diegoomataix/UPMSAT-2-STM-Model-Integration/README.md

# UPMSAT-2-STM-Model-Integration
 Integración modelo STM del UPMSAT-2
