diegoomataix/UPMSAT-2-STM-Model-Integration/STM check list.docx

STM ASSEMBLY – CHECK LIST

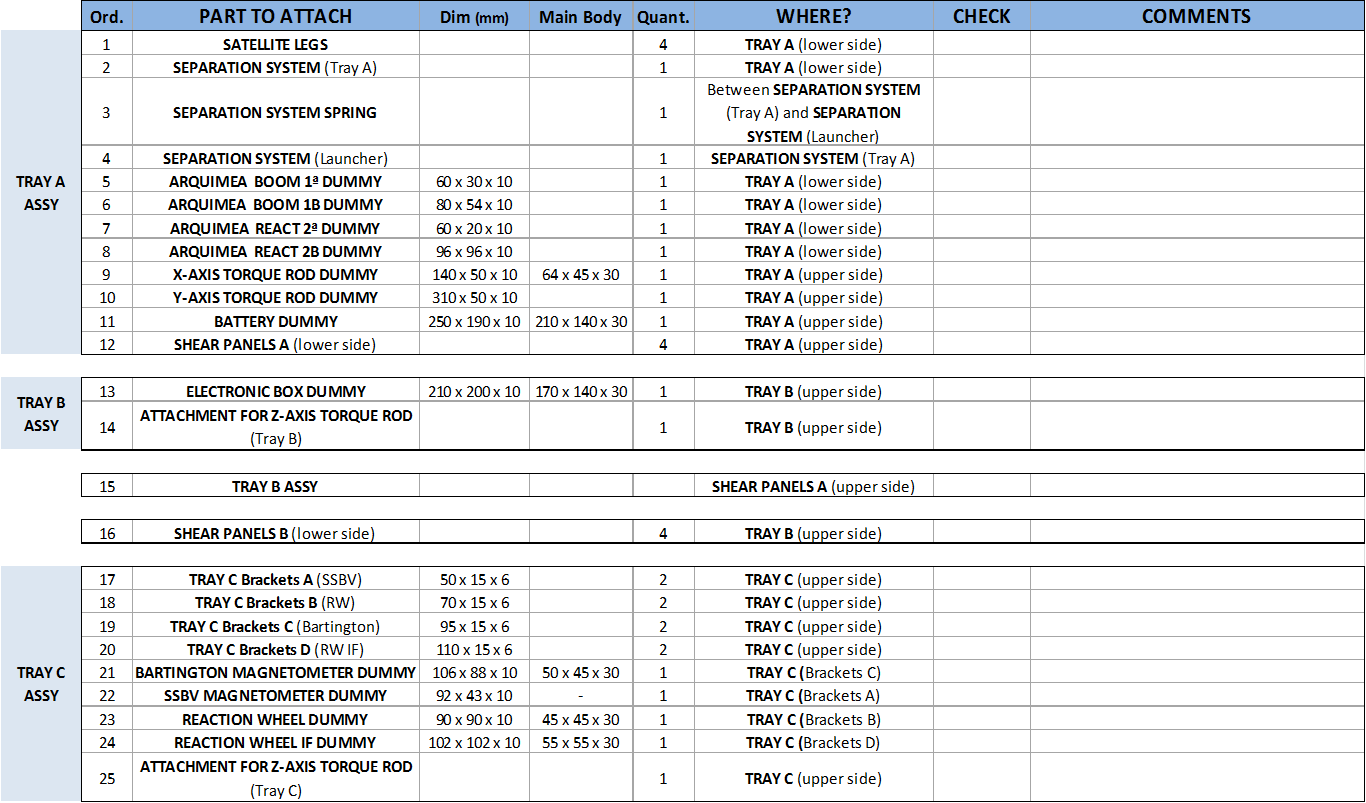
[picture p1: figure]

STM ASSEMBLY – FIXING ELEMENTS CHECK LIST
