diegoomataix/UPMSAT-2-STM-Model-Integration/qr_code_udf2.pdf

MUSE IDR

LEVEL | Bill of Material: US2‐E‐CM‐140000AP‐01A‐T_STM
1 | 2 | 3 | 4 | 5 | Part Number | Source | Definition | Material
x | | | | | US2‐E‐CM‐140100CP‐04H‐T_STRA | Made | TRAY A | EN AW 7075 | US2‐E‐CM‐140100CP‐04H‐T_STRA (TRAY A)
| x | | | | US2‐E‐CM‐BATTERY_DUMMY_SOLID_CP‐01A‐T | Made | BATTERY DUMMY SOLID | EN AW 7075 | US2‐E‐CM‐BATTERY_DUMMY_SOLID_CP‐01A‐T (BATTERY DUMMY SOLID)
| x | | | | US2‐E‐CM‐XTR_DUMMY_SOLID_CP‐01A‐T | Made | XTR DUMMY SOLID | EN AW 7075 | US2‐E‐CM‐XTR_DUMMY_SOLID_CP‐01A‐T (XTR DUMMY SOLID)
| x | | | | US2‐E‐CM‐YTR_DUMMY_CP‐01A‐T | Made | Y‐AXIS TORQUE ROD DUMMY | EN AW 7075 | US2‐E‐CM‐YTR_DUMMY_CP‐01A‐T (Y‐AXIS TORQUE ROD DUMMY)
| x | | | | US2‐E‐CM‐140130CP‐04A‐T_SSHP X+ | Made | SHEAR PANEL X+ | EN AW 7075 | US2‐E‐CM‐140130CP‐04A‐T_SSHP X+ (SHEAR PANEL X+)
| x | | | | US2‐E‐CM‐140130CP‐04A‐T_SSHP Y+ | Made | SHEAR PANEL Y+ | EN AW 7075 | US2‐E‐CM‐140130CP‐04A‐T_SSHP Y+ (SHEAR PANEL Y+)
| x | | | | US2‐E‐CM‐140130CP‐04A‐T_SSHP X‐ | Made | SHEAR PANEL X‐ | EN AW 7075 | US2‐E‐CM‐140130CP‐04A‐T_SSHP X‐ (SHEAR PANEL X‐)
| x | | | | US2‐E‐CM‐140130CP‐04A‐T_SSHP Y‐ | Made | SHEAR PANEL Y‐ | EN AW 7075 | US2‐E‐CM‐140130CP‐04A‐T_SSHP Y‐ (SHEAR PANEL Y‐)
x | | | | | US2‐E‐CM‐140200CP‐03B‐T_STRB | Made | TRAY B | EN AW 7075 | US2‐E‐CM‐140200CP‐03B‐T_STRB (TRAY B)
| x | | | | US2‐E‐CM‐EBOX_DUMMY_SOLID_CP‐01A‐T | Made | EBOX DUMMY SOLID | EN AW 7075 | US2‐E‐CM‐EBOX_DUMMY_SOLID_CP‐01A‐T (EBOX DUMMY SOLID)
| x | | | | US2‐E‐CM‐ZTR_DUMMY_CP‐01A‐T | Made | Z‐AXIS TORQUE ROD DUMMY | EN AW 7075 | US2‐E‐CM‐ZTR_DUMMY_CP‐01A‐T (Z‐AXIS TORQUE ROD DUMMY)
| | x | | | US2‐E‐CM‐140350CP‐01A‐T_BRKTMTR15 | Made | BRACKET MAGNETO‐TORQUE MTR15 DUMMY | EN AW 7075 | US2‐E‐CM‐140350CP‐01A‐T_BRKTMTR15 (BRACKET MAGNETO‐TORQUE MTR15 DUMMY)
| | x | | | US2‐E‐CM‐130221CP‐01A‐T_GRMTR‐15 | Made | GRIP MTR‐15 DUMMY | EN AW 7075 | US2‐E‐CM‐130221CP‐01A‐T_GRMTR‐15 (GRIP MTR‐15 DUMMY)
| x | | | | US2‐E‐CM‐140230CP‐02A‐T_SSHP X+ | Made | SHEAR PANEL X+ | EN AW 7075 | US2‐E‐CM‐140230CP‐02A‐T_SSHP X+ (SHEAR PANEL X+)
| x | | | | US2‐E‐CM‐140230CP‐02A‐T_SSHP Y+ | Made | SHEAR PANEL Y+ | EN AW 7075 | US2‐E‐CM‐140230CP‐02A‐T_SSHP Y+ (SHEAR PANEL Y+)
| x | | | | US2‐E‐CM‐140230CP‐02A‐T_SSHP X‐ | Made | SHEAR PANEL X‐ | EN AW 7075 | US2‐E‐CM‐140230CP‐02A‐T_SSHP X‐ (SHEAR PANEL X‐)
| x | | | | US2‐E‐CM‐140230CP‐02A‐T_SSHP Y‐ | Made | SHEAR PANEL Y‐ | EN AW 7075 | US2‐E‐CM‐140230CP‐02A‐T_SSHP Y‐ (SHEAR PANEL Y‐)
x | | | | | US2‐E‐CM‐140300CP‐03A‐T_STRC | Made | TRAY C | EN AW 7075 | US2‐E‐CM‐140300CP‐03A‐T_STRC (TRAY C)
| | x | | | US2‐E‐CM‐140350CP‐01A‐T_BRKTMTR15 | Made | BRACKET MAGNETO‐TORQUE MTR15 DUMMY | EN AW 7075 | US2‐E‐CM‐140350CP‐01A‐T_BRKTMTR15 (BRACKET MAGNETO‐TORQUE MTR15 DUMMY)
| | x | | | US2‐E‐CM‐130221CP‐01A‐T_GRMTR‐15 | Made | GRIP MTR‐15 DUMMY | EN AW 7075 | US2‐E‐CM‐130221CP‐01A‐T_GRMTR‐15 (GRIP MTR‐15 DUMMY)
| x | | | | US2‐E‐CM‐140310CP‐01A‐T_STR | Made | BRACKET MAG | EN AW 7075 | US2‐E‐CM‐140310CP‐01A‐T_STR (BRACKET MAG)
| x | | | | US2‐E‐CM‐BARTINGTON_DUMMY_SOLID_CP‐01A‐T | Made | BARTINGTON DUMMY SOLID | EN AW 7075 | US2‐E‐CM‐BARTINGTON_DUMMY_SOLID_CP‐01A‐T (BARTINGTON DUMMY SOLID)
| x | | | | US2‐E‐CM‐140320CP‐01A‐T_STR | Made | BRACKET MGMT | EN AW 7075 | US2‐E‐CM‐140320CP‐01A‐T_STR (BRACKET MGMT)
| x | | | | US2‐E‐CM‐SSBV_DUMMY_CP‐01A‐T | Made | SSBV DUMMY | EN AW 7075 | US2‐E‐CM‐SSBV_DUMMY_CP‐01A‐T (SSBV DUMMY)
| x | | | | US2‐E‐CM‐140330CP‐01A‐T_STR | Made | BRACKET MECH | EN AW 7075 | US2‐E‐CM‐140330CP‐01A‐T_STR (BRACKET MECH)
| x | | | | US2‐E‐CM‐RW_DUMMY_SOLID_CP‐01A‐T | Made | RW DUMMY SOLID | EN AW 7075 | US2‐E‐CM‐RW_DUMMY_SOLID_CP‐01A‐T (RW DUMMY SOLID)
| x | | | | US2‐E‐CM‐140340CP‐01A‐T_STR | Made | BRACKET LAP‐SSL | EN AW 7075 | US2‐E‐CM‐140340CP‐01A‐T_STR (BRACKET LAP‐SSL)
| x | | | | US2‐E‐CM‐RW_IF_DUMMY_SOLID_CP‐01A‐T | Made | RW IF DUMMY SOLID | EN AW 7075 | US2‐E‐CM‐RW_IF_DUMMY_SOLID_CP‐01A‐T (RW IF DUMMY SOLID)
x | | | | | US2‐E‐CM‐140510CP‐01A‐T_SPD 1 | Made | SEPARATOR DUMMY 1 | EN AW 7075 | US2‐E‐CM‐140510CP‐01A‐T_SPD 1 (SEPARATOR DUMMY 1)
x | | | | | US2‐E‐CM‐140610CP‐01A‐T_SPD 2 | Made | SEPARATOR DUMMY 2 | EN AW 7075 | US2‐E‐CM‐140610CP‐01A‐T_SPD 2 (SEPARATOR DUMMY 2)
x | | | | | US2‐E‐CM‐140610CP‐01A‐T_SPD 3 | Made | SEPARATOR DUMMY 3 | EN AW 7075 | US2‐E‐CM‐140610CP‐01A‐T_SPD 3 (SEPARATOR DUMMY 3)
x | | | | | US2‐E‐CM‐140610CP‐01A‐T_SPD 4 | Made | SEPARATOR DUMMY 4 | EN AW 7075 | US2‐E‐CM‐140610CP‐01A‐T_SPD 4 (SEPARATOR DUMMY 4)
x | | | | | US2‐E‐CM‐140400CP‐04B‐T_STRD | Made | TRAY D | EN AW 7075 | US2‐E‐CM‐140400CP‐04B‐T_STRD (TRAY D)
| x | | | | US2‐E‐CM‐140411CP‐01B‐T_BRKTD | Made | BRACKET D | EN AW 7075 | US2‐E‐CM‐140411CP‐01B‐T_BRKTD (BRACKET D)
| x | | | | US2‐E‐CM‐125200CP‐01A‐T_TSPD | Made | TOP SUPPORT PANEL DUMMY | EN AW 7075 | US2‐E‐CM‐125200CP‐01A‐T_TSPD (TOP SUPPORT PANEL DUMMY)
| x | | | | US2‐E‐CM‐MTS_DUMMY_CP‐01A‐T | Made | MTS IBERESPACIO DUMMY | EN AW 7075 | US2‐E‐CM‐MTS_DUMMY_CP‐01A‐T (MTS IBERESPACIO DUMMY)
x | | | | | US2‐E‐CM‐140910CP‐01A‐T_LPD X+ | Made | LATERAL PANEL DUMMY X+ | EN AW 7075 | US2‐E‐CM‐140910CP‐01A‐T_LPD X+ (LATERAL PANEL DUMMY X+)
x | | | | | US2‐E‐CM‐140910CP‐01A‐T_LPD Y+ | Made | LATERAL PANEL DUMMY Y+ | EN AW 7075 | US2‐E‐CM‐140910CP‐01A‐T_LPD Y+ (LATERAL PANEL DUMMY Y+)
x | | | | | US2‐E‐CM‐140910CP‐01A‐T_LPD X‐ | Made | LATERAL PANEL DUMMY X‐ | EN AW 7075 | US2‐E‐CM‐140910CP‐01A‐T_LPD X‐ (LATERAL PANEL DUMMY X‐)
x | | | | | US2‐E‐CM‐140910CP‐01A‐T_LPD Y‐ | Made | LATERAL PANEL DUMMY Y‐ | EN AW 7075 | US2‐E‐CM‐140910CP‐01A‐T_LPD Y‐ (LATERAL PANEL DUMMY Y‐)
x | | | | | US2‐E‐CM‐121220CP‐01A‐T X+ | Made | SUPPORT PANEL DUMMY X+ | EN AW 7075 | US2‐E‐CM‐121220CP‐01A‐T X+ (SUPPORT PANEL DUMMY X+)
| x | | | | US2‐E‐CM‐MODULE_DUMMY01_CP‐01A‐T | Made | MODULE DUMMY 01 | EN AW 7075 | US2‐E‐CM‐MODULE_DUMMY01_CP‐01A‐T (MODULE DUMMY 01)
| x | | | | US2‐E‐CM‐MODULE_DUMMY02_CP‐01A‐T | Made | MODULE DUMMY 02 | EN AW 7075 | US2‐E‐CM‐MODULE_DUMMY02_CP‐01A‐T (MODULE DUMMY 02)
x | | | | | US2‐E‐CM‐121220CP‐01A‐T Y+ | Made | SUPPORT PANEL DUMMY Y+ | EN AW 7075 | US2‐E‐CM‐121220CP‐01A‐T Y+ (SUPPORT PANEL DUMMY Y+)
| x | | | | US2‐E‐CM‐MODULE_DUMMY01_CP‐01A‐T | Made | MODULE DUMMY 01 | EN AW 7075 | US2‐E‐CM‐MODULE_DUMMY01_CP‐01A‐T (MODULE DUMMY 01)
| x | | | | US2‐E‐CM‐MODULE_DUMMY02_CP‐01A‐T | Made | MODULE DUMMY 02 | EN AW 7075 | US2‐E‐CM‐MODULE_DUMMY02_CP‐01A‐T (MODULE DUMMY 02)
x | | | | | US2‐E‐CM‐121220CP‐01A‐T X‐ | Made | SUPPORT PANEL DUMMY X‐ | EN AW 7075 | US2‐E‐CM‐121220CP‐01A‐T X‐ (SUPPORT PANEL DUMMY X‐)
| x | | | | US2‐E‐CM‐MODULE_DUMMY01_CP‐01A‐T | Made | MODULE DUMMY 01 | EN AW 7075 | US2‐E‐CM‐MODULE_DUMMY01_CP‐01A‐T (MODULE DUMMY 01)
| x | | | | US2‐E‐CM‐MODULE_DUMMY02_CP‐01A‐T | Made | MODULE DUMMY 02 | EN AW 7075 | US2‐E‐CM‐MODULE_DUMMY02_CP‐01A‐T (MODULE DUMMY 02)
x | | | | | US2‐E‐CM‐121220CP‐01A‐T Y‐ | Made | SUPPORT PANEL DUMMY Y‐ | EN AW 7075 | US2‐E‐CM‐121220CP‐01A‐T Y‐ (SUPPORT PANEL DUMMY Y‐)
| x | | | | US2‐E‐CM‐MODULE_DUMMY01_CP‐01A‐T | Made | MODULE DUMMY 01 | EN AW 7075 | US2‐E‐CM‐MODULE_DUMMY01_CP‐01A‐T (MODULE DUMMY 01)
| x | | | | US2‐E‐CM‐MODULE_DUMMY02_CP‐01A‐T | Made | MODULE DUMMY 02 | EN AW 7075 | US2‐E‐CM‐MODULE_DUMMY02_CP‐01A‐T (MODULE DUMMY 02)
19/09/2018 | 1 | qr_code_udf2.xlsm
