diegoomataix/UPMSAT-2-STM-Model-Integration/tabla check list STM_v2.xlsx

Sheet: Check List STM
 | Ord. | PART TO ATTACH | Dim (mm) | Main Body | Quant. | WHERE? | CHECK | COMMENTS
TRAY A ASSY | 1 | SATELLITE LEGS |  |  | 4 | TRAY A (lower side)
 | 2 | SEPARATION SYSTEM (Tray A) |  |  | 1 | TRAY A (lower side)
 | 3 | SEPARATION SYSTEM SPRING |  |  | 1 | Between SEPARATION SYSTEM (Tray A) and SEPARATION SYSTEM (Launcher)
 | 4 | SEPARATION SYSTEM (Launcher) |  |  | 1 | SEPARATION SYSTEM (Tray A)
 | 5 | ARQUIMEA BOOM 1ª DUMMY | 60 x 30 x 10 |  | 1 | TRAY A (lower side)
 | 6 | ARQUIMEA BOOM 1B DUMMY | 80 x 54 x 10 |  | 1 | TRAY A (lower side)
 | 7 | ARQUIMEA REACT 2ª DUMMY | 60 x 20 x 10 |  | 1 | TRAY A (lower side)
 | 8 | ARQUIMEA REACT 2B DUMMY | 96 x 96 x 10 |  | 1 | TRAY A (lower side)
 | 9 | X-AXIS TORQUE ROD DUMMY | 140 x 50 x 10 | 64 x 45 x 30 | 1 | TRAY A (upper side)
 | 10 | Y-AXIS TORQUE ROD DUMMY | 310 x 50 x 10 |  | 1 | TRAY A (upper side)
 | 11 | BATTERY DUMMY | 250 x 190 x 10 | 210 x 140 x 30 | 1 | TRAY A (upper side)
 | 12 | SHEAR PANELS A (lower side) |  |  | 4 | TRAY A (upper side)
TRAY B ASSY | 13 | ELECTRONIC BOX DUMMY | 210 x 200 x 10 | 170 x 140 x 30 | 1 | TRAY B (upper side)
 | 14 | ATTACHMENT FOR Z-AXIS TORQUE ROD (Tray B) |  |  | 1 | TRAY B (upper side)
 | 15 | TRAY B ASSY |  |  |  | SHEAR PANELS A (upper side)
 | 16 | SHEAR PANELS B (lower side) |  |  | 4 | TRAY B (upper side)
TRAY C ASSY | 17 | TRAY C Brackets A (SSBV) | 50 x 15 x 6 |  | 2 | TRAY C (upper side)
 | 18 | TRAY C Brackets B (RW) | 70 x 15 x 6 |  | 2 | TRAY C (upper side)
 | 19 | TRAY C Brackets C (Bartington) | 95 x 15 x 6 |  | 2 | TRAY C (upper side)
 | 20 | TRAY C Brackets D (RW IF) | 110 x 15 x 6 |  | 2 | TRAY C (upper side)
 | 21 | BARTINGTON MAGNETOMETER DUMMY | 106 x 88 x 10 | 50 x 45 x 30 | 1 | TRAY C (Brackets C)
 | 22 | SSBV MAGNETOMETER DUMMY | 92 x 43 x 10 | - | 1 | TRAY C (Brackets A)
 | 23 | REACTION WHEEL DUMMY | 90 x 90 x 10 | 45 x 45 x 30 | 1 | TRAY C (Brackets B)
 | 24 | REACTION WHEEL IF DUMMY | 102 x 102 x 10 | 55 x 55 x 30 | 1 | TRAY C (Brackets D)
 | 25 | ATTACHMENT FOR Z-AXIS TORQUE ROD (Tray C) |  |  | 1 | TRAY C (upper side)
 | 26 | TRAY C ASSY |  |  |  | SHEAR PANELS B (upper side)
 | 27 | Z-AXIS TORQUE ROD DUMMY | 8,4 x 238 (cylinder) | - | 1 | ATTACHMENTS FOR Z-AXIS TORQUE ROD (Tray B and Tray C)
 | 28 | SEPARATORS 1, 2, 3 y 4 |  |  | 4 | TRAY A, TRAY B and TRAY C (lateral sides)
 | 29 | TOP PHOTOVOLTAIC CELL DUMMIES |  |  | 4 | TOP SUPPORT PANEL (Z+) | Attached
TRAY D ASSY | 30 | BRACKETS TRAY D |  |  | 4 | TRAY D (upper side)
 | 31 | IBERESPACIO MTS DUMMY | 161 x 114 x 10 | - | 1 | TRAY D (upper side)
 | 32 | TOP SUPPORT PANEL (Z+) |  |  | 1 | TRAY D (upper side)
 | 33 | TRAY D ASSY |  |  |  | SEPARATORS 1, 2, 3 y 4
 | 34 | LATERAL BRAKETS |  |  | 16 | LATERAL PANELS X+, X-, Y+, Y- | Attached
 | 35 | LATERAL PANELS X+ |  |  | 1 | SEPARATORS and TRAYS
 | 36 | LATERAL PANELS X- |  |  | 1 | SEPARATORS and TRAYS
 | 37 | LATERAL PANELS Y+ |  |  | 1 | SEPARATORS and TRAYS
 | 38 | LATERAL PANELS Y- |  |  | 1 | SEPARATORS and TRAYS
 | 39 | LATERAL PHOTOVOLTAIC CELL DUMMIES |  |  | 32 | LATERAL SUPPORT PANELS X+, X-, Y+, Y- |  | Y+ and Y- Attached
 | 40 | LATERAL SUPPORT PANELS X+ |  |  | 1 | LATERAL PANELS X+
 | 41 | LATERAL SUPPORT PANELS X- |  |  | 1 | LATERAL PANELS X-
 | 42 | LATERAL SUPPORT PANELS Y+ |  |  | 1 | LATERAL PANELS Y+
 | 43 | LATERAL SUPPORT PANELS Y- |  |  | 1 | LATERAL PANELS Y-

Sheet: Fixing Elements STM
RECUENTO DE ELEMENTOS DE FIJACIÓN STM
 |  |  | Screw |  |  |  |  |  |  |  |  |  |  | Plain Washer |  |  | Nut | Standoff
 |  |  | M3 |  |  |  |  | M4 |  |  | M5 | M6 | M8 | M3 | M4 | M5 | M3 | M3
 | INTERFACE |  | EN-ISO-4762-M3x06 | EN-ISO-4762-M3x08 | EN-ISO-4762-M3x10 | EN-ISO-4762-M3x12 | EN-ISO-4762-M3x16 | EN-ISO-4762-M4x10 | EN-ISO-4762-M4x12 | EN-ISO-4762-M4x16 | EN-ISO-4762-M5x20 | SEP. SYSTEM M6 | SEP. SYSTEM M8 LIP BOLT | EN-ISO-7089-M3x7 | EN-ISO-7089-M4x9 | EN-ISO-7089-M5x10 | EN-ISO-4032-M3 | C45503 SP1106 M3x05-L6 (M/F) | C45503 SP1106 M3x05-L10 (M/F) | C45503 SP1920 M3x05-L20 (F/F)
 | SEPARATION SYSTEM (TRAY A) | TRAY A (Lower side) |  |  |  |  |  |  |  |  |  | 12 | 1
 | ARQ BOOM 1A | TRAY A (Lower side) |  |  |  |  | 2 |  |  |  |  |  |  | 4 |  |  | 2
 | ARQ BOOM 1B | TRAY A (Lower side) |  |  |  |  | 2 |  |  |  |  |  |  | 4 |  |  | 2
 | ARQ REACT 2A | TRAY A (Lower side) |  |  |  |  | 2 |  |  |  |  |  |  | 4 |  |  | 2
 | ARQ REACT 2B | TRAY A (Lower side) |  |  | 3 |  |  |  |  |  |  |  |  | 3
 | X-AXIS TORQUE ROD SUP | X-AXIS TORQUE ROD INF |  |  |  |  |  |  |  |  | 4
 | X-AXIS TORQUE ROD (SUP+INF) | TRAY A (Upper side) |  |  |  |  | 4 |  |  |  |  |  |  | 8 |  |  | 4
 | Y-AXIS TORQUE ROD | TRAY A (Upper side) |  |  |  |  | 4 |  |  |  |  |  |  | 8 |  |  | 4
 | BATTERY SUP | BATTERY INF |  |  |  |  |  |  |  |  | 6
 | BATTERY DUMMY (SUP+INF) | TRAY A (Upper side) |  |  |  |  |  |  |  | 8 |  |  |  |  | 8
 | TYPE A SHEAR PANELS | TRAY A (Upper side) & TRAY B (Lower side) |  |  |  |  |  | 32 |  |  |  |  |  |  | 32
 | EBOX SUP | EBOX INF |  |  |  |  |  |  |  |  | 6
 | EBOX DUMMY (SUP+INF) | TRAY B (Upper side) |  |  |  |  | 6 |  |  |  |  |  |  | 12 |  |  | 6
 | ATTACHMENT Z-AXIS | TRAY B (Upper side) |  |  | 4 |  |  |  |  |  |  |  |  | 4
 | TYPE B SHEAR PANELS | TRAY B (Upper side) & TRAY C (Lower side) |  |  |  |  |  | 32 |  |  |  |  |  |  | 32
 | ATTACHMENT Z-AXIS | TRAY C (Upper side) |  |  | 4 |  |  |  |  |  |  |  |  | 4
 | TRAY C BRACKETS (A) | TRAY C (Upper side) | 4 |  |  |  |  |  |  |  |  |  |  | 4
 | TRAY C BRACKETS (B) | TRAY C (Upper side) | 4 |  |  |  |  |  |  |  |  |  |  | 4
 | TRAY C BRACKETS (C) | TRAY C (Upper side) | 4 |  |  |  |  |  |  |  |  |  |  | 4
 | TRAY C BRACKETS (D) | TRAY C (Upper side) | 4 |  |  |  |  |  |  |  |  |  |  | 4
 | SSBV DUMMY | TRAY C BRACKETS (A) |  |  |  |  | 4 |  |  |  |  |  |  | 4
 | REACT. WHEEL SUP | REACT. WHEEL INF |  |  |  |  |  |  |  |  | 4
 | REACT.WHEEL DUMMY (SUP+INF) | TRAY C BRACKETS (B) |  |  |  |  | 4 |  |  |  |  |  |  | 4
 | BARTINGTON SUP | BARTINGTON INF |  |  |  |  |  |  |  |  | 4
 | BARTINGTON DUMMY (SUP+INF) | TRAY C BRACKETS (C) |  |  |  |  | 4 |  |  |  |  |  |  | 4
 | RW IF DUMMY | TRAY C BRACKETS (D) |  |  |  |  | 4 |  |  |  |  |  |  | 4
 | X-AXIS TORQUE ROD | ATTACHMENT Z-AXIS (TRAY B & TRAY C) |  |  | 4 |  |  |  |  | 2 |  |  |  | 4
 | L-PROFILE BEAMS | TRAYS A, B, C & D |  |  |  |  |  |  |  | 32 |  |  |  |  | 32
 | TRAY D BRACKETS | TRAY D (Upper side) |  | 8
 | MTS DUMMY | TRAY D (Upper side) |  |  |  |  | 8 |  |  |  |  |  |  | 8 |  |  |  |  |  | 4
 | LATERAL BRACKETS (Lower) | LATERAL PANELS (X+, X-, Y+, Y-) |  | 8 |  |  |  |  |  |  |  |  |  | 8
 | LATERAL BRACKETS (Middle) | LATERAL PANELS (X+, X-, Y+, Y-) |  | 8 |  |  |  |  |  |  |  |  |  | 8
 | LATERAL BRACKETS (Upper) | LATERAL PANELS (X+, X-, Y+, Y-) |  | 16 |  |  |  |  |  |  |  |  |  | 16
 | LATERAL PANELS (X+, X-, Y+, Y-) | L-PROFILE BEAMS |  | 104 |  |  |  |  |  |  |  |  |  | 104
 | LATERAL PANELS (X+, X-, Y+, Y-) | TRAYS A, B, C & D |  | 80 |  |  |  |  |  |  |  |  |  | 80
 | LATERAL SUPPORT PANELS (X+, X-, Y+, Y-) | L-PROFILE BEAMS & LATERAL BRACKETS | 152 |  |  |  |  |  |  |  |  |  |  | 152 |  |  |  | 120
 | PHOTOVOLTAIC CELL DUMMIES | LATERAL SUPPORT PANELS | 192 |  |  |  |  |  |  |  |  |  |  | 192
 | PHOTOVOLTAIC CELL DUMMIES | TOP SUPPORT PANEL | 24 |  |  |  |  |  |  |  |  |  |  | 24
 | TOP SUPPORT PANEL | TRAY D BRACKETS | 6 |  |  |  |  |  |  |  |  |  |  | 6 |  |  |  |  | 2
 |  | TOTAL | 390 | 224 | 15 | 0 | 44 | 64 | 0 | 42 | 24 | 12 | 1 | 685 | 104 | 0 | 20 | 120 | 2 | 4
 |  |  |  |  |  |  |  |  |  |  |  |  |  |  |  |  |  |  |  |  |  |  | Total
 |  |  |  |  |  |  |  |  |  |  |  |  |  |  |  |  |  |  |  |  | Screw | EN-ISO-4762-M3x06 | 390
 |  |  |  |  |  |  |  |  |  |  |  |  |  |  |  |  |  |  |  |  |  | EN-ISO-4762-M3x08 | 224
 |  |  |  |  |  |  |  |  |  |  |  |  |  |  |  |  |  |  |  |  |  | EN-ISO-4762-M3x10 | 15
 |  |  |  |  |  |  |  |  |  |  |  |  |  |  |  |  |  |  |  |  |  | EN-ISO-4762-M3x16 | 44
 |  |  |  |  |  |  |  |  |  |  |  |  |  |  |  |  |  |  |  |  |  | EN-ISO-4762-M4x10 | 64
 |  |  |  |  |  |  |  |  |  |  |  |  |  |  |  |  |  |  |  |  |  | EN-ISO-4762-M4x16 | 42
 |  |  |  |  |  |  |  |  |  |  |  |  |  |  |  |  |  |  |  |  |  | EN-ISO-4762-M5x20 | 24
 |  |  |  |  |  |  |  |  |  |  |  |  |  |  |  |  |  |  |  |  |  | SEP. SYSTEM M6 | 12
 |  |  |  |  |  |  |  |  |  |  |  |  |  |  |  |  |  |  |  |  |  | SEP. SYSTEM M8 LIP BOLT | 1
 |  |  |  |  |  |  |  |  |  |  |  |  |  |  |  |  |  |  |  |  | Washer | EN-ISO-7089-M3x7 | 685
 |  |  |  |  |  |  |  |  |  |  |  |  |  |  |  |  |  |  |  |  |  | EN-ISO-7089-M4x9 | 104
 |  |  |  |  |  |  |  |  |  |  |  |  |  |  |  |  |  |  |  |  |  | EN-ISO-7089-M5x10 | 0
 |  |  |  |  |  |  |  |  |  |  |  |  |  |  |  |  |  |  |  |  | Nut | EN-ISO-4032-M3 | 20
 |  |  |  |  |  |  |  |  |  |  |  |  |  |  |  |  |  |  |  |  | Standoff | C45503 SP1106 - M3x05-L6 (M/F) | 120
 |  |  |  |  |  |  |  |  |  |  |  |  |  |  |  |  |  |  |  |  |  | C45503 SP1106 - M3x05-L10 (M/F) | 2
 |  |  |  |  |  |  |  |  |  |  |  |  |  |  |  |  |  |  |  |  |  | C45503 SP1920 - M3x05-L20 (F/F) | 4
