diegoomataix/UPMSAT-2-STM-Model-Integration/(list of files, cad)

Other CAD files:
MODELOS 3D/STM/CP/Dummies/ARQUIMEA BOOM/AP/US2-E-CM-BOOM_DUMMY_AP-01A-T.CATProduct
MODELOS 3D/STM/CP/Dummies/ARQUIMEA BOOM/CP/US2-E-CM-BOOM_DUMMY1A_CP-01A-T.CATPart
MODELOS 3D/STM/CP/Dummies/ARQUIMEA BOOM/CP/US2-E-CM-BOOM_DUMMY1B_CP-01A-T.CATPart
MODELOS 3D/STM/CP/Dummies/ARQUIMEA REACT/AP/US2-E-CM-REACT_DUMMY_AP-01A-T.CATProduct
MODELOS 3D/STM/CP/Dummies/ARQUIMEA REACT/CP/US2-E-CM-REACT_DUMMY2A_CP-01A-T.CATPart
MODELOS 3D/STM/CP/Dummies/ARQUIMEA REACT/CP/US2-E-CM-REACT_DUMMY2B_CP-01A-T.CATPart
MODELOS 3D/STM/CP/Dummies/BARTINGTON/AP/US2-E-CM-BARTINGTON_DUMMY_AP-01A-T.CATProduct
MODELOS 3D/STM/CP/Dummies/BARTINGTON/CP/US2-E-CM-BARTINGTON_DUMMY_BASE_CP-01A-T.CATPart
MODELOS 3D/STM/CP/Dummies/BARTINGTON/CP/US2-E-CM-BARTINGTON_DUMMY_SOLID_CP-01A-T.CATPart
MODELOS 3D/STM/CP/Dummies/BATTERY/AP/US2-E-CM-BATTERYDUMMY_AP-01A-T.CATProduct
MODELOS 3D/STM/CP/Dummies/BATTERY/CP/US2-E-CM-BATTERY_DUMMY_BASE_CP-01A-T.CATPart
MODELOS 3D/STM/CP/Dummies/BATTERY/CP/US2-E-CM-BATTERY_DUMMY_SOLID_CP-01A-T.CATPart
MODELOS 3D/STM/CP/Dummies/EBOX/AP/US2-E-CM-EBOX_DUMMY_AP-01A-T.CATProduct
MODELOS 3D/STM/CP/Dummies/EBOX/CP/US2-E-CM-EBOX_DUMMY_BASE_CP-01A-T.CATPart
MODELOS 3D/STM/CP/Dummies/EBOX/CP/US2-E-CM-EBOX_DUMMY_SOLID_CP-01A-T.CATPart
MODELOS 3D/STM/CP/Dummies/EP DUMMIES/AP/US2-E-CM-121000AP-01A-T.CATProduct
MODELOS 3D/STM/CP/Dummies/EP DUMMIES/AP/US2-E-CM-125000AP-01A-T.CATProduct
MODELOS 3D/STM/CP/Dummies/EP DUMMIES/CP/US2-E-CM-MODULE_DUMMY01_CP-01A-T.CATPart
MODELOS 3D/STM/CP/Dummies/EP DUMMIES/CP/US2-E-CM-MODULE_DUMMY02_CP-01A-T.CATPart
MODELOS 3D/STM/CP/Dummies/MTS/AP/US2-E-CM-MTS_DUMMY_AP-01A-T.CATProduct
MODELOS 3D/STM/CP/Dummies/MTS/CP/US2-E-CM-MTS_DUMMY_CP-01A-T.CATPart
MODELOS 3D/STM/CP/Dummies/RW IF/AP/US2-E-CM-RW_IF_DUMMY_AP-01A-T.CATProduct
MODELOS 3D/STM/CP/Dummies/RW IF/CP/US2-E-CM-RW_IF_DUMMY_BASE_CP-01A-T.CATPart
MODELOS 3D/STM/CP/Dummies/RW IF/CP/US2-E-CM-RW_IF_DUMMY_SOLID_CP-01A-T.CATPart
MODELOS 3D/STM/CP/Dummies/RW/AP/US2-E-CM-RW_DUMMY_AP-01A-T.CATProduct
MODELOS 3D/STM/CP/Dummies/RW/CP/US2-E-CM-RW_DUMMY_BASE_CP-01A-T.CATPart
MODELOS 3D/STM/CP/Dummies/RW/CP/US2-E-CM-RW_DUMMY_SOLID_CP-01A-T.CATPart
MODELOS 3D/STM/CP/Dummies/SSBV/AP/US2-E-CM-SSBV_DUMMY_AP-01A-T.CATProduct
MODELOS 3D/STM/CP/Dummies/SSBV/CP/US2-E-CM-SSBV_DUMMY_CP-01A-T.CATPart
MODELOS 3D/STM/CP/Dummies/XTR/AP/US2-E-CM-X_TORQUE_ROD_AP-01A-T.CATProduct
MODELOS 3D/STM/CP/Dummies/XTR/CP/US2-E-CM-XTR_DUMMY_BASE_CP-01A-T.CATPart
MODELOS 3D/STM/CP/Dummies/XTR/CP/US2-E-CM-XTR_DUMMY_SOLID_CP-01A-T.CATPart
MODELOS 3D/STM/CP/Dummies/YTR/AP/US2-E-CM-Y_TORQUE_ROD_AP-01A-T.CATProduct
MODELOS 3D/STM/CP/Dummies/YTR/CP/US2-E-CM-YTR_DUMMY_CP-01A-T.CATPart
MODELOS 3D/STM/CP/Dummies/ZTR/AP/US2-E-CM-Z_TORQUE_ROD_AP-01A-T.CATProduct
MODELOS 3D/STM/CP/Dummies/ZTR/CP/US2-E-CM-130221CP-01A-T.CATPart
MODELOS 3D/STM/CP/Dummies/ZTR/CP/US2-E-CM-140350CP-01A-T.CATPart
MODELOS 3D/STM/CP/Dummies/ZTR/CP/US2-E-CM-ZTR_DUMMY_CP-01A-T.CATPart
MODELOS 3D/STM/CP/FIXING ELEMENTS/233-31-030-030-M3.CATPart
MODELOS 3D/STM/CP/FIXING ELEMENTS/4132-003-0006-M3-B.CATPart
MODELOS 3D/STM/CP/FIXING ELEMENTS/4132-003-0075-M3-2.5d-B.CATPart
MODELOS 3D/STM/CP/FIXING ELEMENTS/4132-004-0008-M4-B.CATPart
MODELOS 3D/STM/CP/FIXING ELEMENTS/4132-005-0075-M5-1.5d-B.CATPart
MODELOS 3D/STM/CP/FIXING ELEMENTS/CHNS3.CATPart
MODELOS 3D/STM/CP/FIXING ELEMENTS/DIN444-M5-12.CATPart
MODELOS 3D/STM/CP/FIXING ELEMENTS/EN-28738-3-A-B.CATPart
MODELOS 3D/STM/CP/FIXING ELEMENTS/EN-28738-4-A-B.CATPart
MODELOS 3D/STM/CP/FIXING ELEMENTS/EN-ISO-4032-M3-A-B.CATPart
MODELOS 3D/STM/CP/FIXING ELEMENTS/EN-ISO-4762-M3x06-B.CATPart
MODELOS 3D/STM/CP/FIXING ELEMENTS/EN-ISO-4762-M3x10-B .CATPart
MODELOS 3D/STM/CP/FIXING ELEMENTS/EN-ISO-4762-M3x10-B.CATPart
MODELOS 3D/STM/CP/FIXING ELEMENTS/EN-ISO-4762-M3x12-B .CATPart
MODELOS 3D/STM/CP/FIXING ELEMENTS/EN-ISO-4762-M3x16-B.CATPart
MODELOS 3D/STM/CP/FIXING ELEMENTS/EN-ISO-4762-M3x20-B.CATPart
MODELOS 3D/STM/CP/FIXING ELEMENTS/EN-ISO-4762-M3x8-B.CATPart
MODELOS 3D/STM/CP/FIXING ELEMENTS/EN-ISO-4762-M4x10-B.CATPart
MODELOS 3D/STM/CP/FIXING ELEMENTS/EN-ISO-4762-M4x12-B.CATPart
MODELOS 3D/STM/CP/FIXING ELEMENTS/EN-ISO-4762-M4x16-01A-B.CATPart
MODELOS 3D/STM/CP/FIXING ELEMENTS/EN-ISO-4762-M5x30-B.CATPart
MODELOS 3D/STM/CP/FIXING ELEMENTS/EN-ISO-7089-M3x7-B.CATPart
MODELOS 3D/STM/CP/FIXING ELEMENTS/EN-ISO-7089-M5x10-B.CATPart
MODELOS 3D/STM/CP/FIXING ELEMENTS/FWB3-47-E6-F6.CATPart
MODELOS 3D/STM/CP/FIXING ELEMENTS/R30-1001402.CATPart
MODELOS 3D/STM/CP/FIXING ELEMENTS/R30-3000602-B.CATPart
MODELOS 3D/STM/CP/FIXING ELEMENTS/R30-3000902-B.CATPart
MODELOS 3D/STM/CP/FIXING ELEMENTS/R30-4003502.CATPart
MODELOS 3D/STM/CP/US2-E-CM-100001CP-01A-T.CATPart
MODELOS 3D/STM/CP/US2-E-CM-121220CP-01A-T.CATPart
MODELOS 3D/STM/CP/US2-E-CM-125200CP-01A-T.CATPart
MODELOS 3D/STM/CP/US2-E-CM-140130CP-04A-T.CATPart
MODELOS 3D/STM/CP/US2-E-CM-140200CP-03C-T.CATPart
MODELOS 3D/STM/CP/US2-E-CM-140230CP-02A-T.CATPart
MODELOS 3D/STM/CP/US2-E-CM-140300CP-03A-T.CATPart
MODELOS 3D/STM/CP/US2-E-CM-140310CP-01A-T.CATPart
MODELOS 3D/STM/CP/US2-E-CM-140320CP-01A-T.CATPart
MODELOS 3D/STM/CP/US2-E-CM-140330CP-01A-T.CATPart
MODELOS 3D/STM/CP/US2-E-CM-140340CP-01A-T.CATPart
MODELOS 3D/STM/CP/US2-E-CM-140400CP-04B-T.CATPart
MODELOS 3D/STM/CP/US2-E-CM-140411CP-01B-T.CATPart
MODELOS 3D/STM/CP/US2-E-CM-140440CP-01A-T.CATPart
MODELOS 3D/STM/CP/US2-E-CM-140510CPCP-01A-T.CATPart
MODELOS 3D/STM/CP/US2-E-CM-140610CP-03A-Tt.CATPart
MODELOS 3D/STM/CP/US2-E-CM-140910CP-01A-T.CATPart
MODELOS 3D/STM/CP/US2-E-CM-140920CP-01A-T.CATPart
MODELOS 3D/STM/CP/US2-E-CM-140930CP-01A-T.CATPart
MODELOS 3D/STM/SEPARATION SYSTEM/AP/US2-E-CM-104100AP-01A-D.CATProduct
MODELOS 3D/STM/SEPARATION SYSTEM/AP/US2-E-CM-104300AP-01A-D.CATProduct
MODELOS 3D/STM/SEPARATION SYSTEM/AP/US2-E-CM-140000AP-01A-D.CATProduct
MODELOS 3D/STM/SEPARATION SYSTEM/CP/EN-ISO-4032-M4-B.CATPart
MODELOS 3D/STM/SEPARATION SYSTEM/CP/EN-ISO-4762-M4x30-B.CATPart
MODELOS 3D/STM/SEPARATION SYSTEM/CP/EN-ISO-4762-M6x12-B.CATPart
MODELOS 3D/STM/SEPARATION SYSTEM/CP/US2-E-CM-104100CP-01A-D.CATPart
MODELOS 3D/STM/SEPARATION SYSTEM/CP/US2-E-CM-140200CP-01A-D.CATPart
MODELOS 3D/STM/SEPARATION SYSTEM/CP/US2-E-CM-140220CP-01A-D.CATPart
MODELOS 3D/STM/SEPARATION SYSTEM/CP/US2-E-CM-140300CP-01A-D.CATPart
MODELOS 3D/STM/SEPARATION SYSTEM/CP/US2-E-CM-140350CP-01A-D.CATPart
MODELOS 3D/STM/SEPARATION SYSTEM/CP/US2-E-CM-140351CP-01A-D.CATPart
MODELOS 3D/STM/SEPARATION SYSTEM/CP/US2-E-CM-140360CP-01A-D.CATPart
